krzsz72/uec2-drone/rtl/top_drone.sv

//******************************************************************************
//       ______________________________________________
//      |                                              |
//      | drone top module                             |
//      |______________________________________________|
//
// Author: Krzysztof Piziak, Szymon Rybak
//******************************************************************************


module top_drone#(
    parameter MAX_TICK = 7'd99 // Changed from 14'd9999 to 7'd99 for 1us tick
) (
        input  logic clk,
        
        input  logic enable,

        output logic [3:0] motor_pwm_out,
        input logic spi_start,
        output logic sclk,
        input logic poci,
        output logic cs_n,
        output logic copi,
        
        output logic [3:0] an,
        output logic [7:0] sseg,
        output [15:0] led,
        input logic btnReset,
        input logic [15:0] sw
    );

    timeunit 1ns;
    timeprecision 1ps;

    (* DONT_TOUCH = "true" *) logic [15:0] led_reg;

    
    logic signed [15:0] Kp_roll, Ki_roll, Kd_roll;

    // Wyjścia z regulatorów PID
    logic signed [15:0] pid_roll_out;
    logic signed [15:0] pid_pitch_out;
    logic signed [15:0] pid_yaw_out;

    // Sygnały do debugowania (ROLL)
    logic signed [15:0] pid_error_roll;
    logic signed [31:0] pid_integral_roll;
    logic signed [15:0] pid_derivative_roll;

    // Estymowane kąty dla PID
    logic signed [15:0] estim_roll;
    logic signed [15:0] estim_pitch;

    // Sygnały danych z IMU w formacie Q15.24
    logic signed [39:0] accel_roll_q24, gyro_roll_q24;
    logic signed [39:0] accel_pitch_q24, gyro_pitch_q24;
    logic signed [39:0] gyro_yaw_rate_q24;

    // Sygnały dla miksera
    logic [1:0]  drone_mode;
    logic [15:0] throttle;
    logic        test_mode_active;
    logic [15:0] final_throttle;
    logic signed [15:0] final_pid_roll_out;
    logic [14:0] m1_width, m2_width, m3_width, m4_width;
    logic [14:0] m_width[4];

    logic [103:0] spi_transmit;       
    wire spi_done;
    logic [103:0] spi_received; //max potrzebuje zmiescic 6x2x8bit = 96b +8bit padding z komendy kontrolera
    logic [6:0] data_length;
    logic [1:0] gyro_state;

    logic gyro_read_done;
    assign gyro_read_done = ((gyro_state==2'b10) & spi_done); 

    gyro #( )
     gyro (
        .clk(clk),
        .rst_n(~btnReset),
        .d_length(data_length),
        .d_out(spi_transmit),
        .ready( (spi_done && sw[15]) | spi_start),
        .gyro_data( (&spi_received[1:0]) ),
        .state_curr(gyro_state),
        .state_prev()
    );

     spi_controller #( )
      spi_controller(
         .clk(clk),
         .rst_n(~btnReset),
         .d_length(data_length),
         .sclk(sclk),
         .cs_n(cs_n),
         .reg_rx(spi_received),
         .reg_tx(spi_transmit),
         .poci(poci),
         .copi(copi),
         .busy(),
         .done(spi_done)
      );

    // Dane z SPI są mapowane na odpowiednie osie i konwertowane do formatu Q15.24
   
    // Oś ROLL (Gyro Y, Accel X)
    convert_gyro #(.WIDTH(16)) conv_gyro_roll (
        .clk(clk),
        .rst_n(~btnReset),
        .gyro_raw_data(spi_received[31:16]), // GYRO_Y
        .data_latch(gyro_read_done),
        .mul_result(gyro_roll_q24),
        // Wyjścia debugujące niepodłączone
        .angle_deg(),
        .angle_raw(),
        .latched_raw()
    );
    convert_accel #(.WIDTH(16)) conv_accel_roll (
        .clk(clk),
        .rst_n(~btnReset),
        .accel_raw_data(spi_received[63:48]), // ACCEL_X
        .data_latch(gyro_read_done),
        .mul_result(accel_roll_q24),
        // Wyjścia debugujące niepodłączone
        .angle_deg(),
        .angle_raw(),
        .latched_raw()
    );

    // Oś PITCH (Gyro X, Accel Y)
    convert_gyro #(.WIDTH(16)) conv_gyro_pitch (
        .clk(clk),
        .rst_n(~btnReset),
        .gyro_raw_data(spi_received[15:0]), // GYRO_X
        .data_latch(gyro_read_done),
        .mul_result(gyro_pitch_q24),
        // Wyjścia debugujące niepodłączone
        .angle_deg(),
        .angle_raw(),
        .latched_raw()
    );
    convert_accel #(.WIDTH(16)) conv_accel_pitch (
        .clk(clk),
        .rst_n(~btnReset),
        .accel_raw_data(spi_received[79:64]), // ACCEL_Y
        .data_latch(gyro_read_done),
        .mul_result(accel_pitch_q24),
        // Wyjścia debugujące niepodłączone
        .angle_deg(),
        .angle_raw(),
        .latched_raw()
    );

    // Oś YAW (Gyro Z)
    convert_gyro #(.WIDTH(16)) conv_gyro_yaw (
        .clk(clk),
        .rst_n(~btnReset),
        .gyro_raw_data(spi_received[47:32]), // GYRO_Z
        .data_latch(gyro_read_done),
        .mul_result(gyro_yaw_rate_q24),
        // Wyjścia debugujące niepodłączone
        .angle_deg(),
        .angle_raw(),
        .latched_raw()
    );

    // --- Estymacja kątów (Filtr komplementarny) ---
    angle_estimator #() estimator_roll (
        .clk(clk),
        .rst_n(~btnReset),
        .accel_data(accel_roll_q24),
        .gyro_data(gyro_roll_q24),
        .angle_deg(estim_roll)
    );

    angle_estimator #() estimator_pitch (
        .clk(clk),
        .rst_n(~btnReset),
        .accel_data(accel_pitch_q24),
        .gyro_data(gyro_pitch_q24),
        .angle_deg(estim_pitch)
    );

    // --- Stałe wzmocnienia dla PITCH i YAW ---
    // Wzmocnienia dla PITCH (takie same jak domyślne dla ROLL)
    localparam signed [15:0] Kp_pitch = 16'sd4096; // P = 1.0
    localparam signed [15:0] Ki_pitch = 16'sd0;     // I = 0.0
    localparam signed [15:0] Kd_pitch = 16'sd205;   // D = ~0.05

    // Wzmocnienia dla YAW 
    localparam signed [15:0] Kp_yaw = 16'sd1024;  // P = 0.25
    localparam signed [15:0] Ki_yaw = 16'sd0;     // I = 0.0
    localparam signed [15:0] Kd_yaw = 16'sd0;     // D = 0.0

    // Wejście dla regulatora YAW (przeskalowana prędkość kątowa)
    logic signed [15:0] yaw_rate_for_pid;
    assign yaw_rate_for_pid = gyro_yaw_rate_q24 >>> 17;

    // --- Logika trybu testowego silników ---
    // Aktywowany przez menu debugowania (sw[14:12] = 111)
    assign test_mode_active = (sw[14:12] == 3'b111);

    always_comb begin
        final_throttle = throttle;
        final_pid_roll_out = pid_roll_out;

        if (test_mode_active) begin
            final_throttle = 16'd1550;
            if (estim_roll > 16'sd128) begin 
                final_pid_roll_out = -16'sd450; 
            end else if (estim_roll < -16'sd128) begin 
                final_pid_roll_out = 16'sd450;  
            end else begin 
                final_pid_roll_out = 16'sd0; 
            end
        end
    end

    // --- Logika wyboru wzmocnień PID za pomocą przełączników ---
    // Kp, Ki, Kd są w formacie Q4.12
    always_comb begin
        // Wybór Kp (1.0 do 2.0) za pomocą sw[11:10]
        case (sw[11:10])
            2'b00: Kp_roll = 16'sd4096;   // P = 1.0
            2'b01: Kp_roll = 16'sd5325;   // P = ~1.3
            2'b10: Kp_roll = 16'sd6963;   // P = ~1.7
            2'b11: Kp_roll = 16'sd8192;   // P = 2.0
            default: Kp_roll = 16'sd0;
        endcase

        // Wybór Ki (0.0 do ~0.001) za pomocą sw[9:8]
        case (sw[9:8])
            2'b00: Ki_roll = 16'sd0;      // I = 0.0
            2'b01: Ki_roll = 16'sd1;      // I = ~0.00025
            2'b10: Ki_roll = 16'sd2;      // I = ~0.0005
            2'b11: Ki_roll = 16'sd4;      // I = ~0.001
            default: Ki_roll = 16'sd0;
        endcase

        // Wybór Kd (0.05 do 0.5) za pomocą sw[7:6]
        case (sw[7:6])
            2'b00: Kd_roll = 16'sd205;    // D = ~0.05
            2'b01: Kd_roll = 16'sd614;    // D = ~0.15
            2'b10: Kd_roll = 16'sd1229;   // D = ~0.3
            2'b11: Kd_roll = 16'sd2048;   // D = 0.5
            default: Kd_roll = 16'sd0;
        endcase
    end

    
    PID #(.WIDTH(16)) pid_roll_inst (
        .clk(clk),
        .rst_n(~btnReset),
        .enable(gyro_read_done), // Obliczenia co nową próbkę
        .estim_roll(estim_roll),
        .Kp(Kp_roll),
        .Ki(Ki_roll),
        .Kd(Kd_roll),
        .pid_output(pid_roll_out),
        .pid_error_out(pid_error_roll),
        .pid_integral_out(pid_integral_roll),
        .pid_derivative_out(pid_derivative_roll)
    );

    PID #(.WIDTH(16)) pid_pitch_inst (
        .clk(clk),
        .rst_n(~btnReset),
        .enable(gyro_read_done),
        .estim_roll(estim_pitch), // Wejście to kąt PITCH
        .Kp(Kp_pitch),
        .Ki(Ki_pitch),
        .Kd(Kd_pitch),
        .pid_output(pid_pitch_out),
        // Wyjścia debugujące niepodłączone
        .pid_derivative_out(),
        .pid_error_out(),
        .pid_integral_out()
    );

    PID #(.WIDTH(16)) pid_yaw_inst (
        .clk(clk),
        .rst_n(~btnReset),
        .enable(gyro_read_done),
        .estim_roll(yaw_rate_for_pid), // Wejście to PRĘDKOŚĆ KĄTOWA YAW
        .Kp(Kp_yaw),
        .Ki(Ki_yaw),
        .Kd(Kd_yaw),
        .pid_output(pid_yaw_out),
        // Wyjścia debugujące niepodłączone
        .pid_derivative_out(),
        .pid_error_out(),
        .pid_integral_out()
    );

    
    // sw[0] (enable) - główne zezwolenie, sw[15] - uzbrojenie
    assign drone_mode = ~enable ? 2'b00 : (sw[15] ? 2'b10 : 2'b01); // 00:INIT, 01:ARMED, 10:RUN
    // Przepustnica z sw[5:0], skalowana do 1000-2016us
    assign throttle = 16'(1000 + ({10'b0, sw[5:0]} << 4));

    // --- Mikser silników ---
    motor_mixer motor_mixer_inst (
        .clk(clk), .rst_n(~btnReset), .mode(drone_mode), .throttle(final_throttle),
        .pid_pitch(pid_pitch_out), .pid_roll(final_pid_roll_out), .pid_yaw(pid_yaw_out),
        .m1_width(m1_width), .m2_width(m2_width), .m3_width(m3_width), .m4_width(m4_width)
    );

    assign m_width[0] = m1_width;
    assign m_width[1] = m2_width;
    assign m_width[2] = m3_width;
    assign m_width[3] = m4_width;

    // Instantiate 4 PWM modules
    genvar i;
    generate
        for (i = 0; i < 4; i = i + 1) begin : pwm_inst
            pwm #( .MAX_TICK(MAX_TICK) ) u_pwm (
                .clk(clk),
                .enable(enable),
                .d_in(m_width[i]),
                .pwm(motor_pwm_out[i]),
                .cnt() //debug odlaczony
            );
        end
    endgenerate

// --- DEKLARACJE POMOCNICZE ---
logic [15:0] disp_hex;


// --- GŁÓWNY BLOK DEBUGGERA ---
always_ff @(posedge clk) begin
    if (btnReset) begin
        led_reg <= 16'b0;
        disp_hex <= '0;
    end 
    else begin
        case(sw[14:12])
            3'b000: disp_hex <= estim_roll;
            3'b001: disp_hex <= estim_pitch;
            3'b010: disp_hex <= pid_roll_out;
            3'b011: disp_hex <= pid_pitch_out;
            3'b100: disp_hex <= pid_yaw_out;
            3'b101: disp_hex <= pid_error_roll;
            3'b110: disp_hex <= pid_integral_roll[15:0];
            3'b111: disp_hex <= {1'b0,m1_width}; // W trybie testowym, pokaż szerokość impulsu M1
            default: disp_hex <= 16'hDEAD;
        endcase
        led_reg <= disp_hex;
    end
end
    
      disp_hex_mux u_display (
        .clk(clk),
        .reset(~btnReset),
        .hex3(disp_hex[15:12]), 
        .hex2(disp_hex[11:8]), 
        .hex1(disp_hex[7:4]), 
        .hex0(disp_hex[3:0]), 
        .dp_in(4'b1111),
        .an(an),
        .sseg(sseg)
    );

    assign led = led_reg;

endmodule
