krzsz72/uec2-drone/rtl/pwm.v

//******************************************************************************
//       ______________________________________________
//      |                                              |
//      | PWM signal generator                         |
//      |______________________________________________|
//
// Author: Krzysztof Piziak, Szymon Rybak
//******************************************************************************


module pwm #(
   parameter MAX_TICK=7'd99, //prescaler
   parameter MAX_PWM=15'd19999    //counter clamp for 1us pwm 50hz: 20ms / 1us = 20000 steps

)
   (
    input wire clk, enable,
    input wire [14:0] d_in,
    output reg pwm,
    output reg [14:0] cnt
   );

   
   // signal declaration
   localparam PRESCALE_W = $clog2(MAX_TICK + 1);
   reg [14:0] D;   //data buffer reg
   reg tick_100us;
   reg [PRESCALE_W-1:0] prescale_cnt;


   always @(posedge clk) begin
      if(!enable)begin
         tick_100us<=1'b0;
         prescale_cnt<=7'd0;
      end else begin
         if(prescale_cnt>=MAX_TICK)begin
            tick_100us<=1'b1;
            prescale_cnt<=7'd0;
         end else begin
            tick_100us<=1'b0;
            prescale_cnt<=prescale_cnt+1'd1;
         end
      end
   end

   always @(posedge clk)begin
       if(!enable)begin
         pwm<=1'b0;
         cnt<=15'd0;
         D<=15'd0;
      end else begin 
         if(tick_100us)begin
            if(cnt>=MAX_PWM)begin
               cnt<=15'd0;
               if(d_in>15'd20000) D<=15'd20000;
               else D<=d_in;
            end else begin
               cnt<=cnt+1'd1;
            end
         end
      end

      pwm <= (cnt<D)? 1'b1 : 1'b0;
   end





endmodule
