krzsz72/uec2-drone/rtl/convert_accel.sv

//******************************************************************************
//       ______________________________________________
//      |                                              |
//      | convert accel                                |
//      |______________________________________________|
//
// Author: Krzysztof Piziak
//******************************************************************************


module convert_accel #(
   parameter int WIDTH=16 //inout registers width
   )
   (
    input logic clk, rst_n,
    input logic signed [WIDTH-1:0] accel_raw_data,
    input logic data_latch,
    output logic signed [WIDTH-1:0] angle_raw, //
    output logic signed [WIDTH-1:0] angle_deg, //used for debug
    output logic signed [WIDTH-1:0] latched_raw, //
    output logic signed [39:0] mul_result
   );

   //uzywamy fixed point arithmetic Q15.24
   logic signed [39:0] mul_result_nxt;
   logic signed [WIDTH-1:0] angle_raw_nxt;
   logic signed [WIDTH-1:0] angle_deg_nxt;
   logic signed [WIDTH-1:0] latched_raw_nxt;
   
   // stała do przemnożenia XL - RAW * (180/(pi * 4098)) * 2^24 = 234569
   localparam logic signed [39:0] XL_COEFF = 40'sd234569;

   // seq block
   always_ff @(posedge clk) begin
      if(!rst_n) begin
         angle_deg <= '0;
         angle_raw <= '0;
         mul_result <= '0;
         latched_raw <= '0;

      end else begin
         angle_deg <= angle_deg_nxt;
         angle_raw <= angle_raw_nxt;
         mul_result <= mul_result_nxt;
         latched_raw <= latched_raw_nxt;
      end
   end

   // fsm block
   always_comb begin
      angle_deg_nxt = angle_deg;
      angle_raw_nxt = angle_raw;
      mul_result_nxt = mul_result;
      latched_raw_nxt = latched_raw;
      
      if(!data_latch)begin
         angle_raw_nxt = {accel_raw_data[7:0],accel_raw_data[15:8]};
      end else begin
         mul_result_nxt = angle_raw * XL_COEFF;
         angle_deg_nxt = mul_result_nxt[39:24] ;
         latched_raw_nxt = angle_raw ;
      end
     end

endmodule
