krzsz72/uec2-drone/(commit log)

2026-06-04 zmiana nazw, constraints, modul pwm.v 1.0
2026-06-04 bitstream gotowy poprawka constraints, porty na topie, top_drone_basys3 warningi dotycza braku portu na cnt z pwm oraz pozotalosci portow na xdc ze starego projektu
2026-06-06 pwm resolution update now res up to 1us from prev 100us. Not tested
2026-06-09 spi copi wyjscie highz dziala spi takt 50MHz
2026-06-09 zdebuggowany highz wyjscie spi testbench ok
2026-06-11 poprawiony spi na gyro 16 bitow, 1MHz
2026-06-13 spi sprawdzone na sprzecie gyro TODO: odczyt rejestru WHO_AM_I (wysw na 7seg i sprawdzenie czy == i wyswietlenie na diodzie) maszyna stanow na: startup, polling
2026-06-13 gyro test jakies wartosci odbiera ale testy trzeba poprawic
2026-06-14 spi chyba dziala testy sprzetowe sprawiaja wiecej problemu niz spi
    [spi_controller_tb.sv, top_drone.sv, top_drone_basys3.sv, top_drone_basys3.xdc]
2026-06-15 test na led OK 7seg jest glupi
2026-06-15 utworzenie modulu praca nad fsm gyro
2026-07-04 who_am_i z modulu gyro
2026-07-06 naprawione bledy syntezy stan debug ledow
    led0 nie dziala (bo spi nie dziala)
    led1 nie dziala (data length nie istnieje..?)
    led2 dziala na btnU tick
    ledy pozostale nic
2026-07-10 naprawione gyro dodany tb pod gyro przed chwila jeszcze dzialalo wszystko z gyro_tb
2026-07-10 dziala gyro_tb
2026-07-17 gyro and spi communiation ok testbench gyro+spi OK
2026-07-19 testbench gyro_spi bezbledny poprawione bugi ze zmiana stanow
    [gyro.sv, gyro_spi_tb.sv, spi_controller.sv, spi_controller_tb.sv]
2026-07-21 pierwszy test na sprzecie spi gyro poprawic test teoretycznie pokazuje cos
2026-07-23 hw test fails cleaned up spi communication bugs visible on sim
    [gyro_spi_tb.sv, spi_controller.sv, top_drone.sv, top_drone_basys3.sv, top_drone_basys3.xdc]
2026-07-24 debug na vivado ila sprawdzic dokladnie dane z gyro czy nie sa przesuniete o 1 bit itd.
2026-07-25 unit_converter jako zatrzask doadtkowo "szacuje" kat z samego gyro
2026-08-13 HW TEST OK dziala gyroY oraz xlRoll komunikacja OK
2026-08-17 Testowanie PID na prawdziwych odczytach z gyro
2026-08-17 full gyro xl debug ready
2026-08-18 dodanie motor mixera oraz pierwszego testu fizycznego
2026-08-18 test PWM na silnikach
2026-08-18 działający test pwm wszystkie silniki
2026-08-18 poprawiony zakres sterowania ESC dla maksymalnego ciągu
2026-08-20 FInalne testy i case optymalizacja w PID
2026-08-24 prescale PID OK
